adamapell/OpenHornet/ECAD/PCBs/ABSIS/ABSIS_OH_Micro/ABSIS_OH_Micro.kicad_pcb

## KiCad design ECAD/PCBs/ABSIS/ABSIS_OH_Micro/ABSIS_OH_Micro.kicad_pcb (2026-10-13)

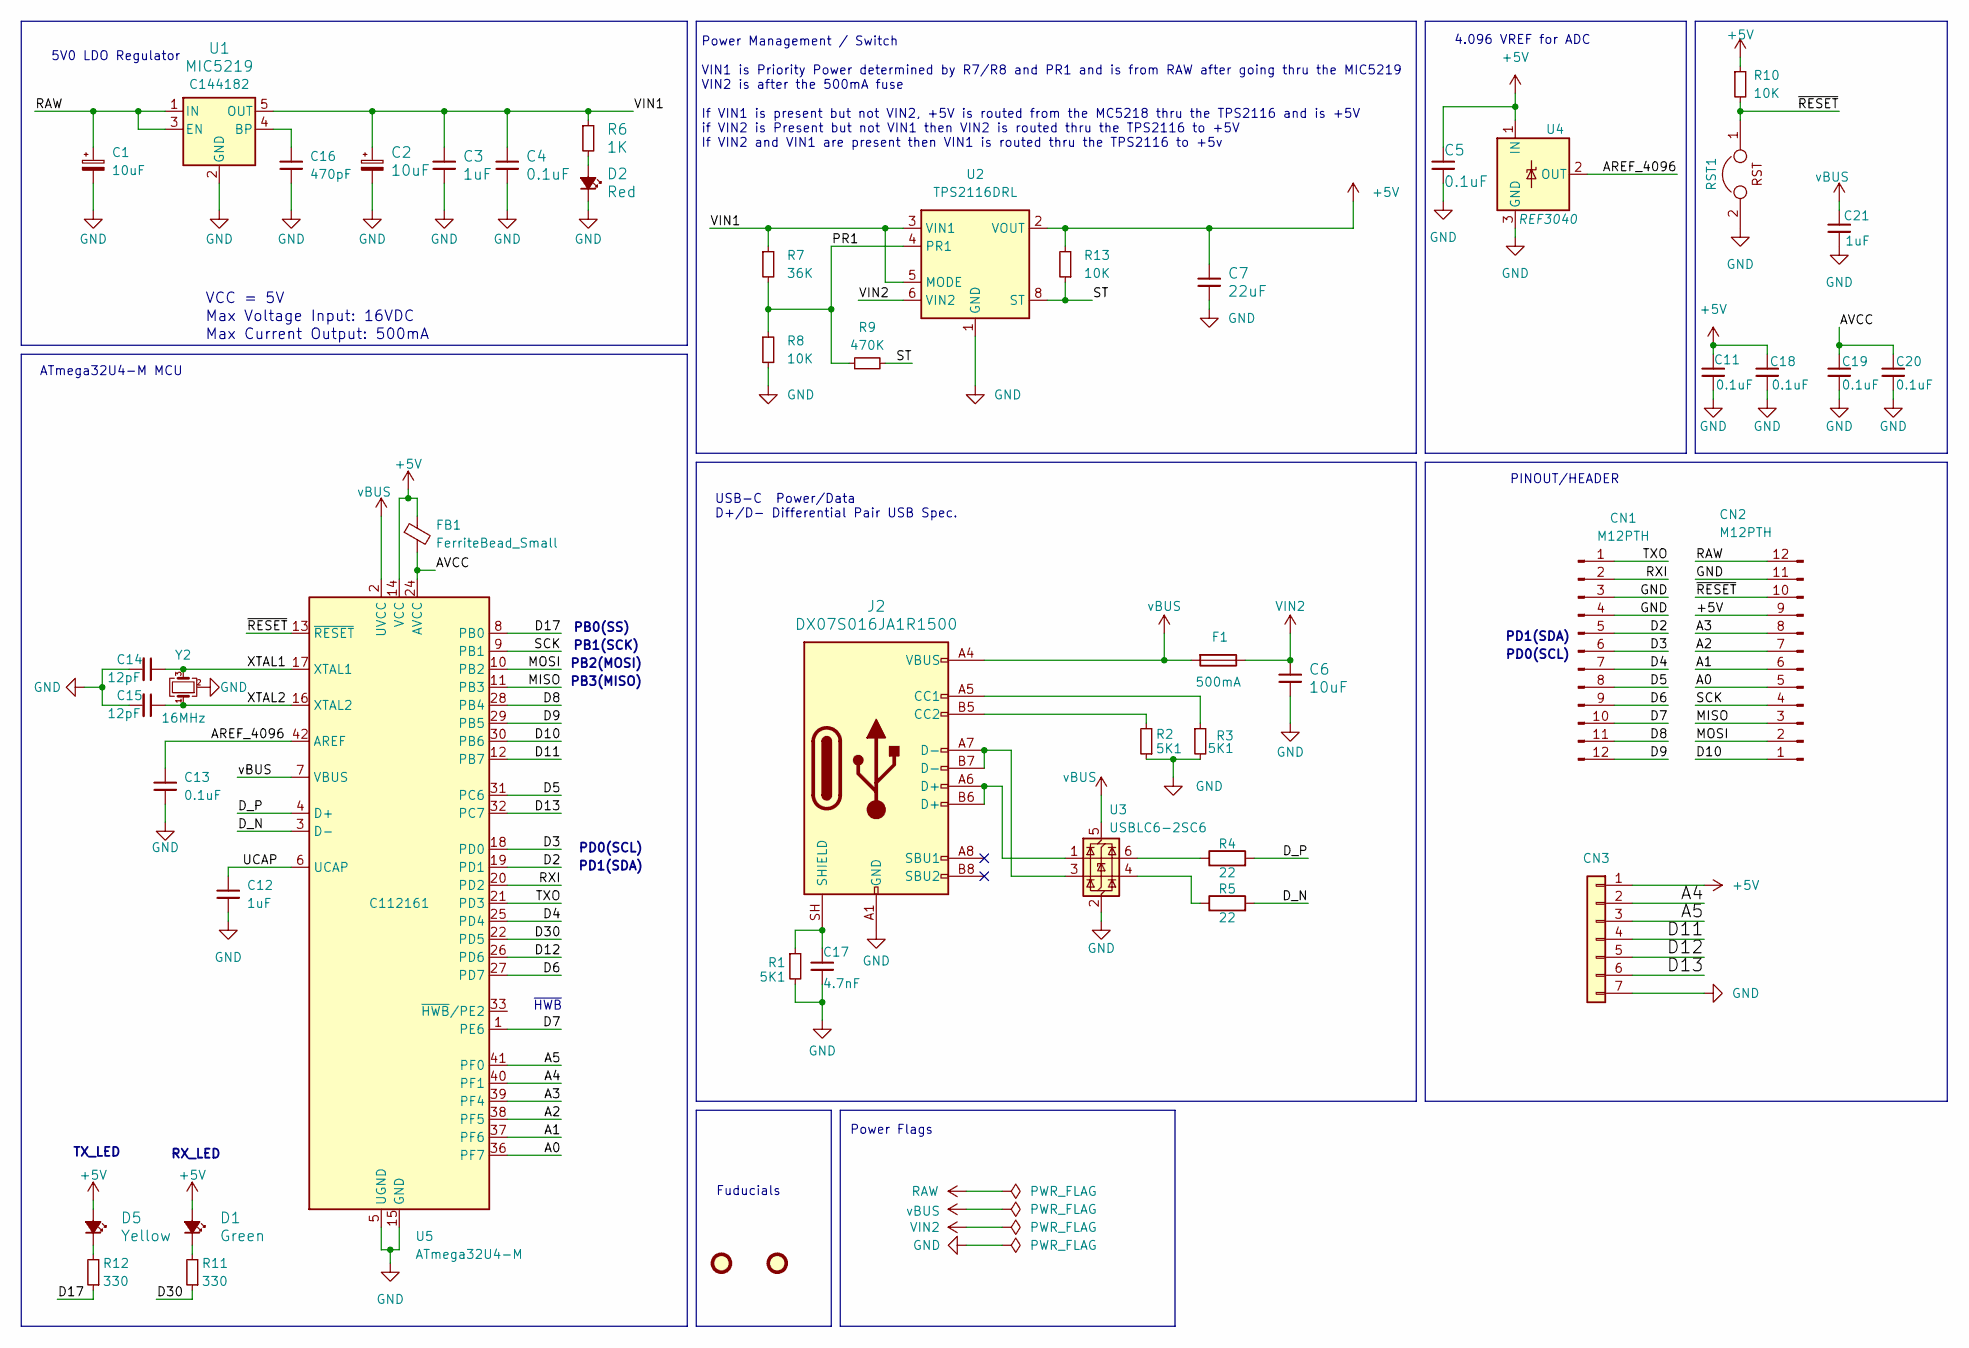
[picture p8: schematic ABSIS_OH_Micro.kicad_sch, ABSIS OH-Micro]

Parts:
C1: 10uF; CP_EIA-3216-18_Kemet-A; LCSC C110055
C2: 10uF; CP_EIA-3216-18_Kemet-A; LCSC Part C110055
C3, C12, C21: 1uF; C_0402_1005Metric; LCSC C1592
C4, C5, C13: 0.1uF; C_0402_1005Metric; LCSC C696360
C6: 10uF; C_0402_1005Metric; LCSC C696360
C7: 22uF; C_0805_2012Metric; LCSC C696360
C11, C18, C19, C20: 0.1uF; C_0402_1005Metric; LCSC C1592
C14, C15: 12pF; C_0402_1005Metric; LCSC C599692
C16: 470pF; C_0402_1005Metric; LCSC C184771
C17: 4.7nF; C_0402_1005Metric; LCSC C1592
CN1, CN2: M12PTH; PinHeader_1x12_P2.54mm_Vertical; LCSC C2840012
CN3: PinHeader_1x06_P2.00mm_Vertical; LCSC C37208
D1: Green; LED_0402_1005Metric; LCSC C74338
D2: Red; LED_0603_1608Metric; LCSC C84263
D5: Yellow; LED_0402_1005Metric; LCSC C434450
F1: 500mA; Fuse_1206_3216Metric; LCSC C136341
FB1: FerriteBead_Small; L_0402_1005Metric
J2: DX07S016JA1R1500; USB_C_Receptacle_JAE_DX07S016JA1R1500; LCSC# C3197885
JP3, JP6: FIDUCIALUFIDUCIAL; Fiducial_0.5mm_Mask1.5mm
R1, R2, R3: 5K1; R_0402_1005Metric; LCSC C844933
R4, R5: 22; R_0402_1005Metric; Manufacturer PN 0603WAF220JT5E; LCSC C23345
R6: 1K; R_0402_1005Metric; LCSC C22548
R7: 36K; R_0402_1005Metric; LCSC C114661
R8, R13: 10K; R_0402_1005Metric; LCSC C99782
R9: 470K; R_0402_1005Metric; LCSC C99782
R10: 10K; R_0402_1005Metric; LCSC C98220
R11, R12: 330; R_0402_1005Metric; LCSC C105881
RST1: RST; SolderJumper-2_P1.3mm_Open_RoundedPad1.0x1.5mm
U1: MIC5219; SOT-23-5; LCSC C144182
U2: TPS2116DRL; SOT-583-8; LCSC C3235557
U3: USBLC6-2SC6; SOT-23-6
U4: REF3040; SOT-23; LCSC C19415
U5: ATmega32U4-M; QFN-44-1EP_7x7mm_P0.5mm_EP5.2x5.2mm; LCSC C112161
Y2: 16MHz; Crystal_SMD_3225-4Pin_3.2x2.5mm; LCSC C13738

Connections:
+5V: C5.2, C7.2, C11.2, C18.2, CN2.9, CN3.1, D1.2 (A), D5.2 (A), FB1.1, R10.1, R13.2, U2.2 (VOUT), U2.7 (VOUT), U4.1 (IN), U5.14 (VCC), U5.34 (VCC)
/A0: CN2.5, U5.36 (PF7)
/A1: CN2.6, U5.37 (PF6)
/A2: CN2.7, U5.38 (PF5)
/A3: CN2.8, U5.39 (PF4)
/A4: CN3.2, U5.40 (PF1)
/A5: CN3.3, U5.41 (PF0)
/AREF_4096: C13.2, U4.2 (OUT), U5.42 (AREF)
/AVCC: C19.2, C20.2, FB1.2, U5.24 (AVCC), U5.44 (AVCC)
/D2: CN1.5, U5.19 (PD1)
/D3: CN1.6, U5.18 (PD0)
/D4: CN1.7, U5.25 (PD4)
/D5: CN1.8, U5.31 (PC6)
/D6: CN1.9, U5.27 (PD7)
/D7: CN1.10, U5.1 (PE6)
/D8: CN1.11, U5.28 (PB4)
/D9: CN1.12, U5.29 (PB5)
/D10: CN2.1, U5.30 (PB6)
/D11: CN3.4, U5.12 (PB7)
/D12: CN3.5, U5.26 (PD6)
/D13: CN3.6, U5.32 (PC7)
/D17: R12.1, U5.8 (PB0)
/D30: R11.1, U5.22 (PD5)
/D_N: R5.2, U5.3 (D-)
/D_P: R4.2, U5.4 (D+)
/MISO: CN2.3, U5.11 (PB3)
/MOSI: CN2.2, U5.10 (PB2)
/PR1: R7.2, R8.1, R9.1, U2.4 (PR1)
/RXI: CN1.2, U5.20 (PD2)
/SCK: CN2.4, U5.9 (PB1)
/ST: R9.2, R13.1, U2.8 (ST)
/TXO: CN1.1, U5.21 (PD3)
/UCAP: C12.2, U5.6 (UCAP)
/VIN1: C2.1, C3.1, C4.2, R6.1, R7.1, U1.5 (OUT), U2.3 (VIN1), U2.5 (MODE)
/XTAL1: C14.1, U5.17 (XTAL1), Y2.3
/XTAL2: C15.1, U5.16 (XTAL2), Y2.1
/~RESET: CN2.10, R10.2, RST1.1, U5.13 (~RESET)
GND: C1.2, C2.2, C3.2, C4.1, C5.1, C6.1, C7.1, C11.1, C12.1, C13.1, C14.2, C15.2, C16.2, C17.1, C18.1, C19.1, C20.1, C21.1, CN1.3, CN1.4, CN2.11, CN3.7, D2.1 (K), J2.A1 (GND), J2.A12 (GND), J2.B1 (GND), J2.B12 (GND), R1.2, R2.1, R3.2, R8.2, RST1.2, U1.2 (GND), U2.1 (GND), U3.2 (GND), U4.3 (GND), U5.5 (UGND), U5.15 (GND), U5.23 (GND), U5.35 (GND), U5.43 (GND), U5.45 (GND), Y2.2 (G), Y2.4 (G)
unnamed: D1.1 (K), R11.2
unnamed: D2.2 (A), R6.2
unnamed: D5.1 (K), R12.2
unnamed: J2.A5 (CC1), R3.1
unnamed: J2.B5 (CC2), R2.2
unnamed: J2.A6 (D+), J2.B6 (D+), U3.1 (I/O1)
unnamed: J2.A7 (D-), J2.B7 (D-), U3.3 (I/O2)
unnamed: C17.2, J2.SH (SHIELD), R1.1
unnamed: R4.1, U3.6 (I/O1)
unnamed: R5.1, U3.4 (I/O2)
unnamed: C16.1, U1.4 (BP)
RAW: C1.1, CN2.12, U1.1 (IN), U1.3 (EN)
VIN2: C6.2, F1.1, U2.6 (VIN2)
vBUS: C21.2, F1.2, J2.A4 (VBUS), J2.A9 (VBUS), J2.B4 (VBUS), J2.B9 (VBUS), U3.5 (VBUS), U5.2 (UVCC), U5.7 (VBUS)

Notes on the sheet:
PB0(SS)
RX_LED
5V0 LDO Regulator
PB2(MOSI)
PD0(SCL)
PB1(SCK)
USB-C Power/Data D+/D- Differential Pair USB Spec.
~{HWB}
4.096 VREF for ADC
Fuducials
PD1(SDA)
Max Voltage Input: 16VDC
TX_LED
Max Current Output: 500mA
ATmega32U4-M MCU
Power Flags
PB3(MISO)
PINOUT/HEADER
VCC = 5V
Power Management / Switch VIN1 is Priority Power determined by R7/R8 and PR1 and is from RAW after going thru the MIC5219 VIN2 is after the 500mA fuse If VIN1 is present but not VIN2, +5V is routed from the MC5218 thru the TPS2116 and is +5V if VIN2 is Present but not VIN1 then VIN2 is routed thru 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

Board: 4 copper layers, 50 parts (4 on the bottom side), 52 nets, no tracks yet.

Other parts of the board:
LOGO: LOGO; LOGO_OH_NoText_Small
