adamapell/OpenHornet/ECAD/PCBs/ABSIS/ABSIS_ALE+/ABSIS ALE+.kicad_pcb

## KiCad design ECAD/PCBs/ABSIS/ABSIS_ALE+/ABSIS ALE+.kicad_pcb (2026-07-24)

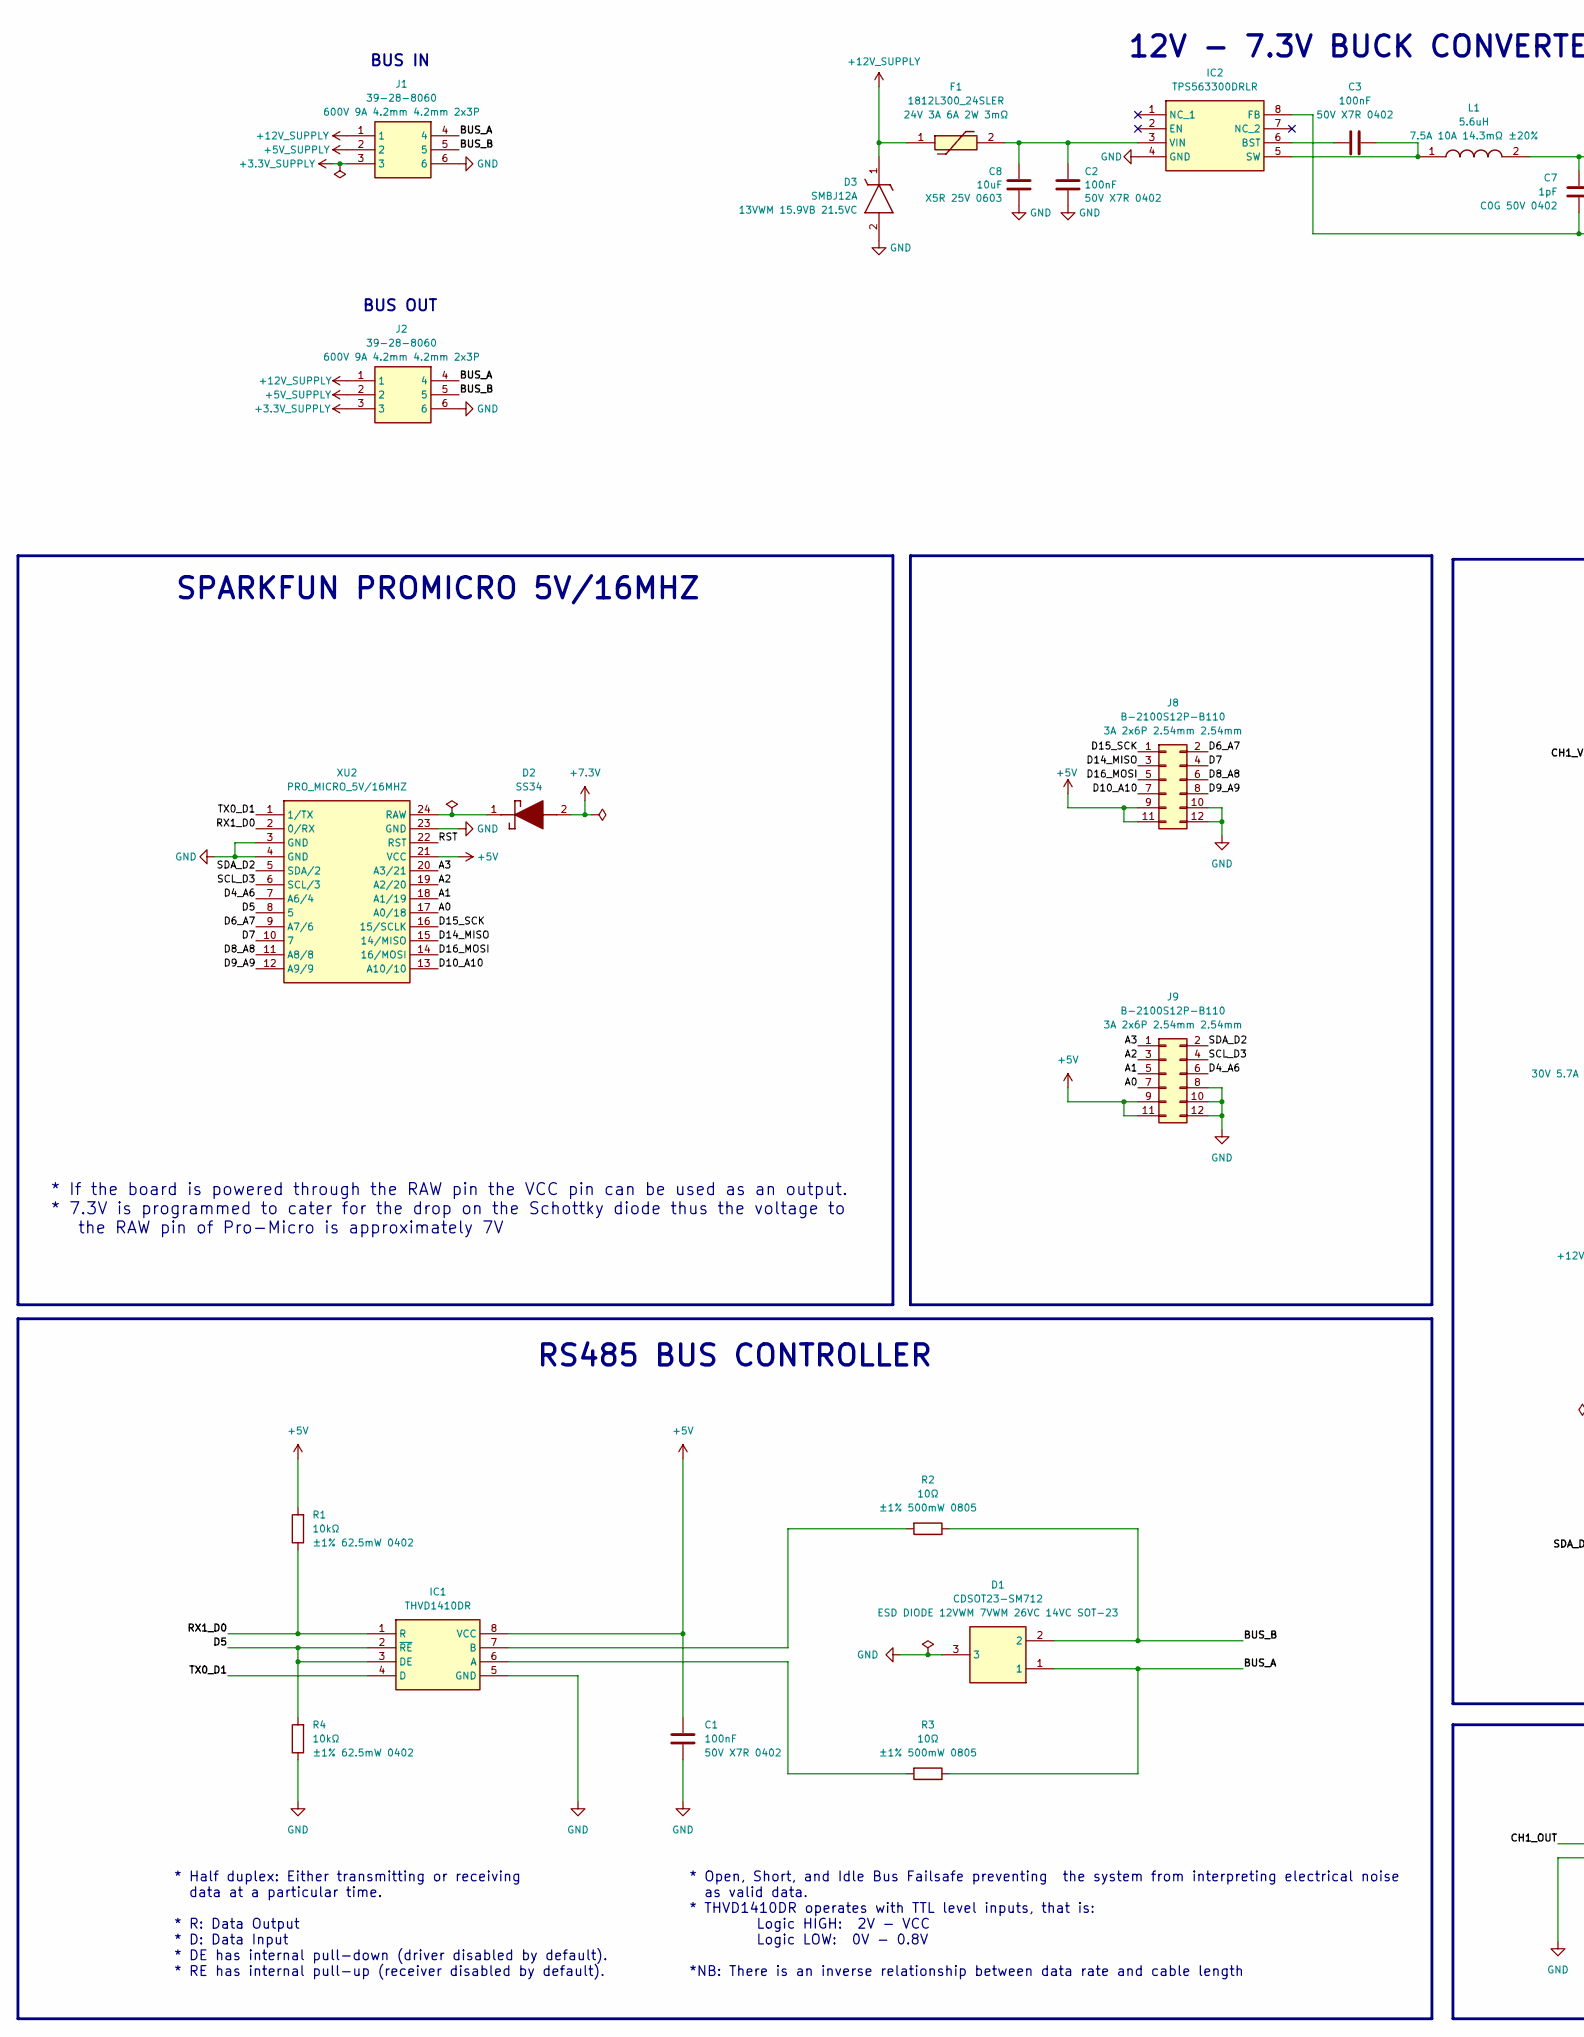
[picture p9: schematic ABSIS ALE+.kicad_sch, ABSIS ALE (ALmost Everything), part in row 1, column 1]

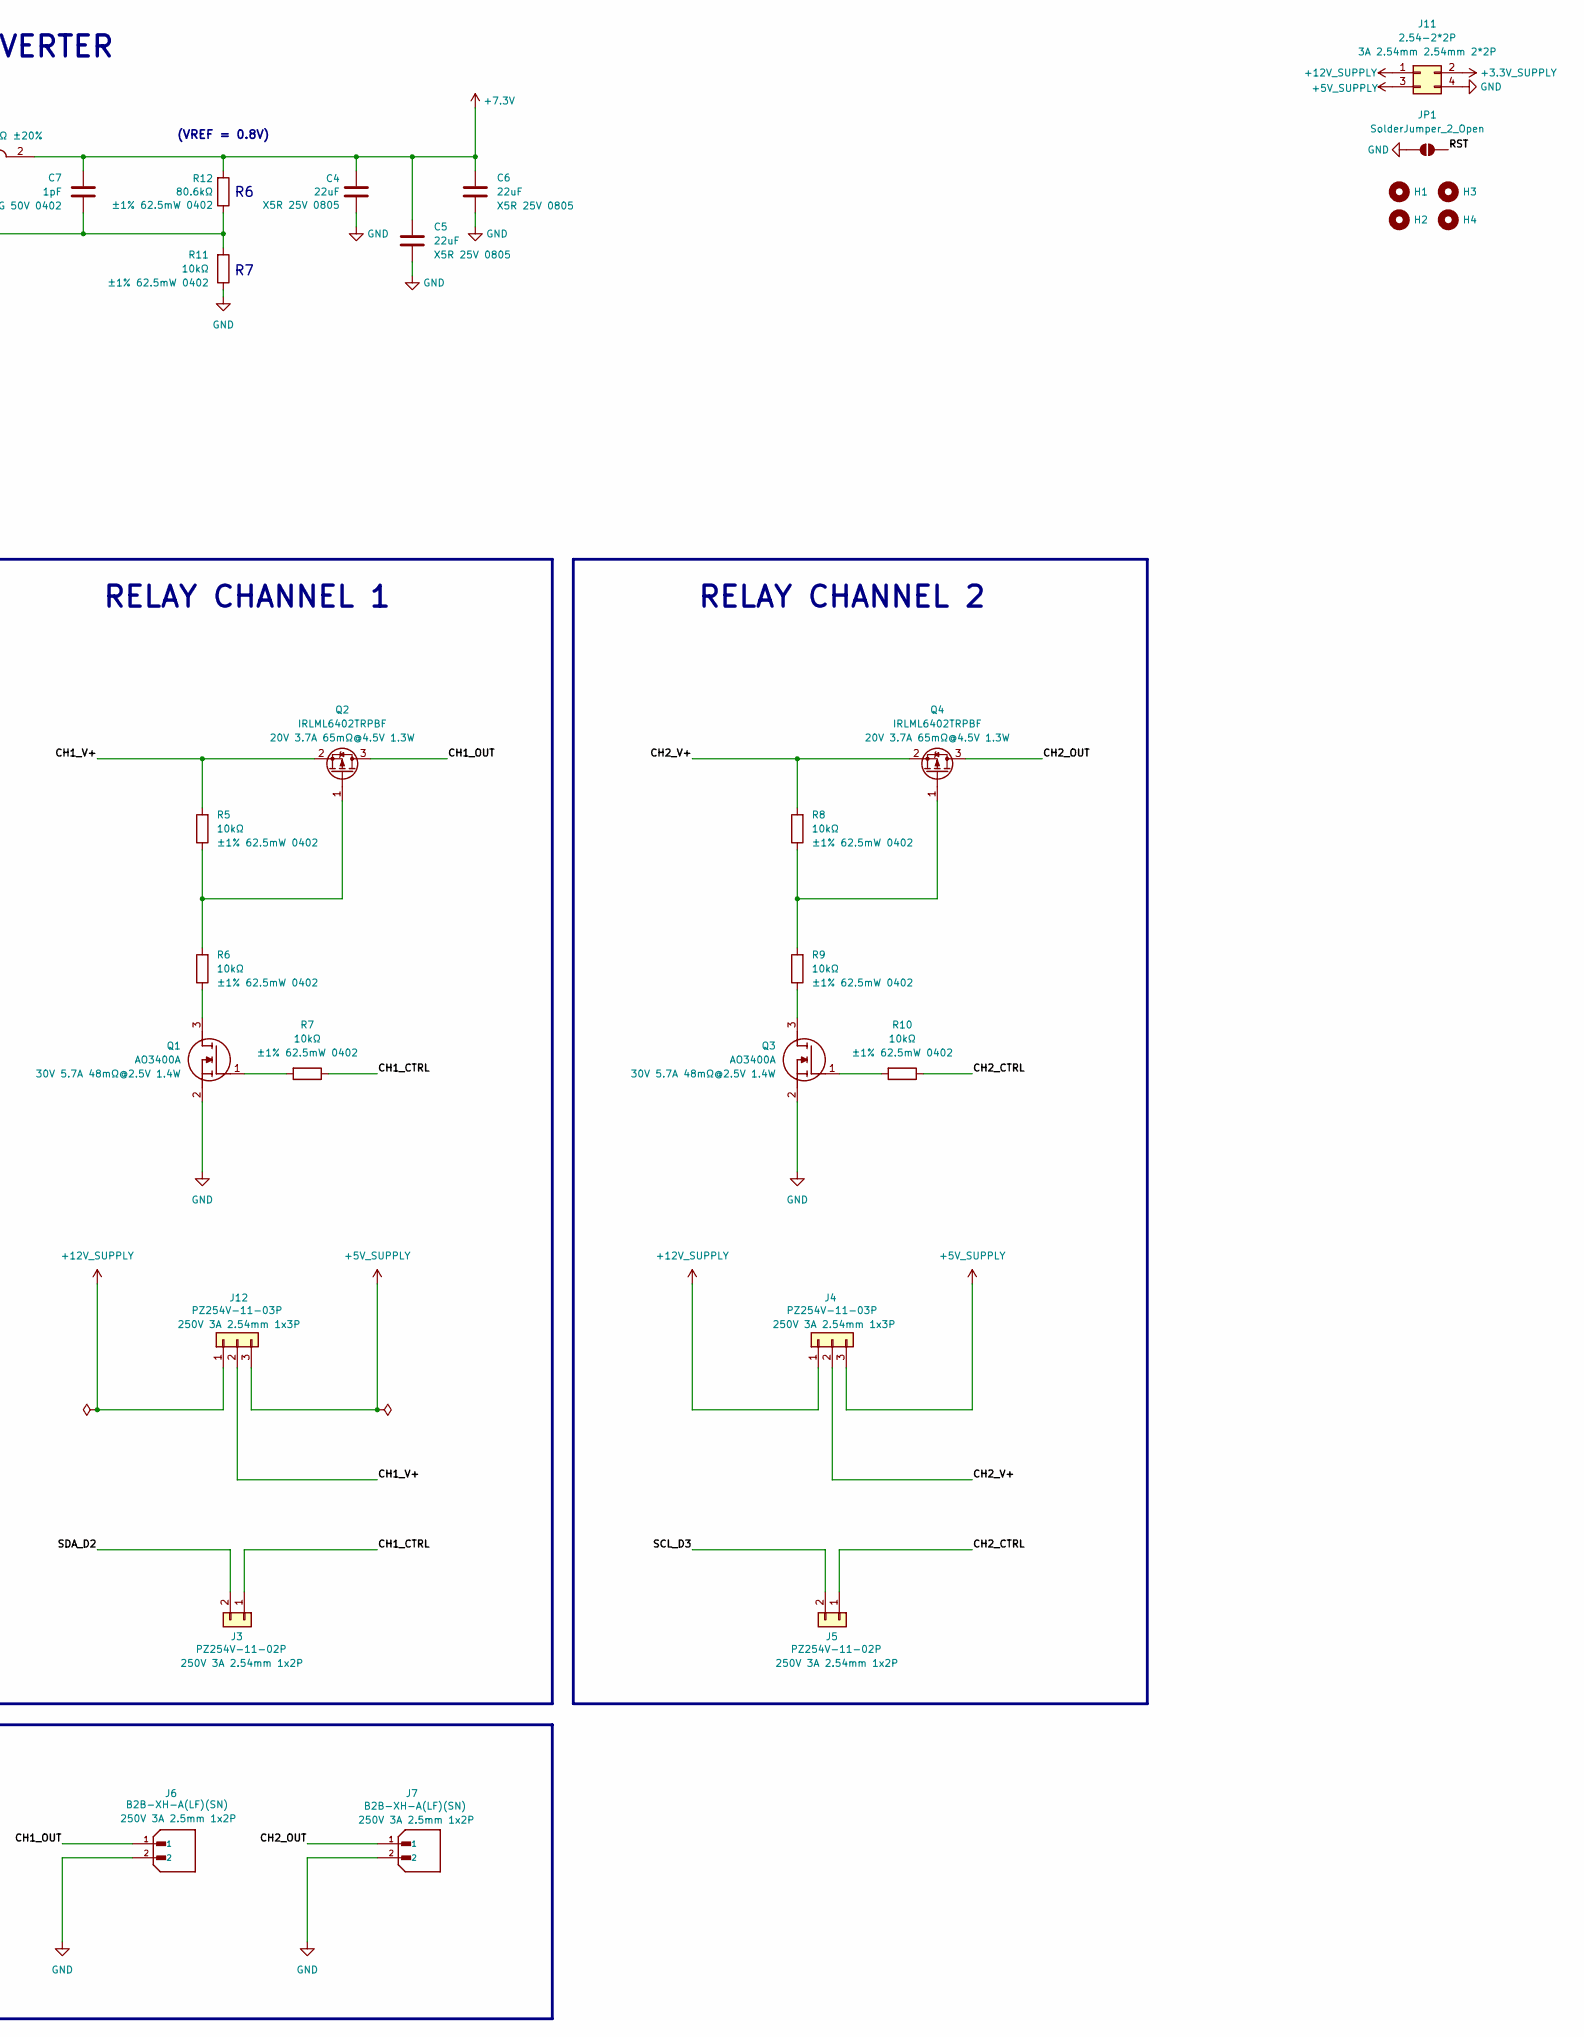
[picture p10: schematic ABSIS ALE+.kicad_sch, ABSIS ALE (ALmost Everything), part in row 1, column 2]

Parts:
C1, C2, C3: 100nF; C_0402_1005Metric; Manufacturer PN CL05B104KB54PNC; LCSC C307331
C4, C5, C6: 22uF; C_0805_2012Metric; Manufacturer PN CL21A226MAQNNNE; LCSC C45783
C7: 1pF; C_0402_1005Metric; Manufacturer PN 0402CG1R0C500NT; LCSC C1550
C8: 10uF; C_0603_1608Metric; Manufacturer PN CL10A106MA8NRNC; LCSC C96446
D1: CDSOT23-SM712; Manufacturer PN CDSOT23-SM712; LCSC C404012
D2: SS34; Manufacturer PN SS34; LCSC C8678
D3: SMBJ12A; Manufacturer PN SMBJ12A; LCSC C151251
F1: 1812L300_24SLER; Manufacturer PN 1812L300/24SLER; LCSC C1512049
H1, H2, H3, H4: MountingHole; MountingHole_3.2mm_M3_DIN965
IC1: THVD1410DR; Manufacturer PN THVD1410DR; LCSC C2671345
IC2: TPS563300DRLR; Manufacturer PN TPS563300DRLR; LCSC C5219249
J1, J2: 39-28-8060; Manufacturer PN 39288060; LCSC C505058
J3, J5: PZ254V-11-02P; PinHeader_1x02_P2.54mm_Vertical; Manufacturer PN PZ254V-11-02P; LCSC C492401
J4, J12: PZ254V-11-03P; PinHeader_1x03_P2.54mm_Vertical; Manufacturer PN PZ254V-11-03P; LCSC C2937625
J6, J7: B2B-XH-A(LF)(SN); B2B-XH-A__LF__SN_; Manufacturer PN B2B-XH-A(LF)(SN); LCSC C158012
J8, J9: B-2100S12P-B110; PinHeader_2x06_P2.54mm_Vertical; Manufacturer PN B-2100S12P-B110; LCSC C124388
J11: 2.54-2*2P; PinHeader_2x02_P2.54mm_Vertical; Manufacturer PN 2.54-2*2P; LCSC C66690
JP1: SolderJumper_2_Open; SolderJumper-2_P1.3mm_Open_RoundedPad1.0x1.5mm
L1: 5.6uH; SRP6060FA-5R6M; Manufacturer PN SRP6060FA-5R6M; LCSC C1332221
Q1, Q3: AO3400A; Manufacturer PN AO3400A; LCSC C20917
Q2, Q4: IRLML6402TRPBF; Manufacturer PN IRLML6402TRPBF; LCSC C2593
R1, R4, R5, R6, R7, R8, R9, R10, R11: 10kΩ; R_0402_1005Metric; Manufacturer PN 0402WGF1002TCE; LCSC C25744
R2, R3: 10Ω; R_0805_2012Metric; Manufacturer PN CRCW080510R0FKEAHP; LCSC C844598
R12: 80.6kΩ; R_0402_1005Metric; Manufacturer PN 0402WGF8062TCE; LCSC C25921
XU2: PRO_MICRO_5V/16MHZ; PRO_MICRO_5V16MHZ; Manufacturer PN PRO_MICRO_5V/16MHZ

Connections:
+3.3V_SUPPLY: J1.3, J2.3, J11.2
+5V: C1.2, IC1.8 (VCC), J8.9, J8.11, J9.9, J9.11, R1.2, XU2.21 (VCC)
+5V_SUPPLY: J1.2, J2.2, J4.3, J11.3, J12.3
+7.3V: C4.1, C5.1, C6.1, C7.1, D2.2 (A), L1.2, R12.2
+12V_SUPPLY: D3.1 (K), F1.1, J1.1, J2.1, J4.1, J11.1, J12.1
/A0: J9.7, XU2.17 (A0/18)
/A1: J9.5, XU2.18 (A1/19)
/A2: J9.3, XU2.19 (A2/20)
/A3: J9.1, XU2.20 (A3/21)
/BUS_A: D1.1, J1.4, J2.4, R3.1
/BUS_B: D1.2, J1.5, J2.5, R2.1
/CH1_CTRL: J3.1, R7.1
/CH1_OUT: J6.1, Q2.3
/CH1_V+: J12.2, Q2.2, R5.2
/CH2_CTRL: J5.1, R10.1
/CH2_OUT: J7.1, Q4.3
/CH2_V+: J4.2, Q4.2, R8.2
/D4_A6: J9.6, XU2.7 (A6/4)
/D5: IC1.2 (~RE), IC1.3 (DE), R4.2, XU2.8 (5)
/D6_A7: J8.2, XU2.9 (A7/6)
/D7: J8.4, XU2.10 (7)
/D8_A8: J8.6, XU2.11 (A8/8)
/D9_A9: J8.8, XU2.12 (A9/9)
/D10_A10: J8.7, XU2.13 (A10/10)
/D14_MISO: J8.3, XU2.15 (14/MISO)
/D15_SCK: J8.1, XU2.16 (15/SCLK)
/D16_MOSI: J8.5, XU2.14 (16/MOSI)
/FB(TPS): C7.2, IC2.8 (FB), R11.2, R12.1
/RST: JP1.2 (B), XU2.22 (RST)
/RX1_D0: IC1.1 (R), R1.1, XU2.2 (0/RX)
/SCL_D3: J5.2, J9.4, XU2.6 (SCL/3)
/SDA_D2: J3.2, J9.2, XU2.5 (SDA/2)
/TX0_D1: IC1.4 (D), XU2.1 (1/TX)
GND: C1.1, C2.1, C4.2, C5.2, C6.2, C8.1, D1.3, D3.2 (A), IC1.5 (GND), IC2.4 (GND), J1.6, J2.6, J6.2, J7.2, J8.10, J8.12, J9.8, J9.10, J9.12, J11.4, JP1.1 (A), Q1.2 (S), Q3.2 (S), R4.1, R11.1, XU2.3 (GND), XU2.4 (GND), XU2.23 (GND)
unnamed: D2.1 (K), XU2.24 (RAW)
unnamed: IC1.6 (A), R3.2
unnamed: IC1.7 (B), R2.2
unnamed: C3.2, IC2.6 (BST)
unnamed: C3.1, IC2.5 (SW), L1.1
unnamed: C2.2, C8.2, F1.2, IC2.3 (VIN)
unnamed: Q1.3 (D), R6.1
unnamed: Q1.1 (G), R7.2
unnamed: Q2.1, R5.1, R6.2
unnamed: Q3.3 (D), R9.1
unnamed: Q3.1 (G), R10.2
unnamed: Q4.1, R8.1, R9.2

Notes on the sheet:
BUS IN
(VREF = 0.8V)
BUS OUT
SPARKFUN PROMICRO 5V/16MHZ
12V - 7.3V BUCK CONVERTER
RELAY CHANNEL 1
* Open, Short, and Idle Bus Failsafe preventing the system from interpreting electrical noise as valid data. * THVD1410DR operates with TTL level inputs, that is: Logic HIGH: 2V - VCC Logic LOW: 0V - 0.8V *NB: There is an inverse relationship between data rate and cable length
RELAY CHANNEL 2
RS485 BUS CONTROLLER
* If the board is powered through the RAW pin the VCC pin can be used as an output. * 7.3V is programmed to cater for the drop on the Schottky diode thus the voltage to the RAW pin of Pro-Micro is approximately 7V
* Half duplex: Either transmitting or receiving data at a particular time. * R: Data Output * D: Data Input * DE has internal pull-down (driver disabled by default). * RE has internal pull-up (receiver disabled by default).

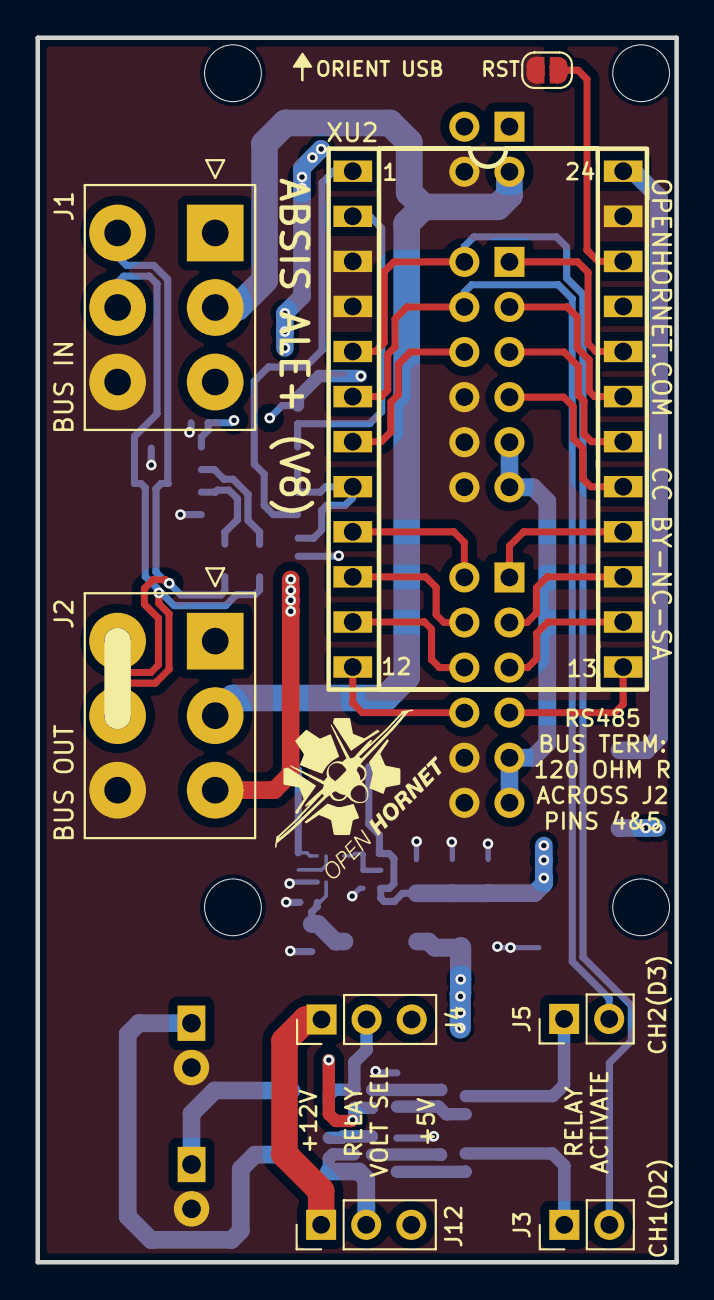
[picture p11: board ABSIS ALE+.kicad_pcb from above]

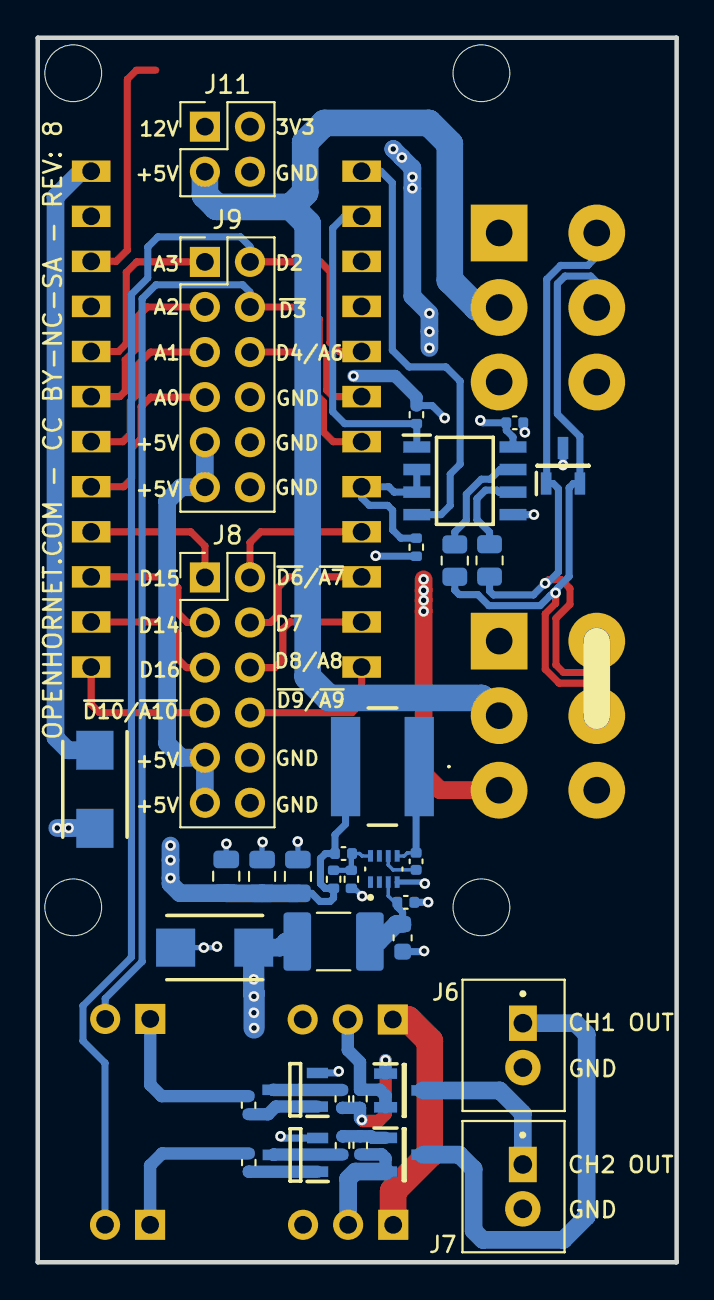
[picture p12: board ABSIS ALE+.kicad_pcb from below]

Board: 4 copper layers, 36.0 x 69.0 mm, 48 parts (36 on the bottom side), 46 nets.
