adamapell/OpenHornet/(commit log)

2026-07-24 Partial ALE+ work
    [ABSIS ALE+.kicad_pcb, ABSIS ALE+.kicad_sch]
2026-10-07 Initial Create of Schematic and PCB outline constraints
