adamapell/OpenHornet/(notices)

Notices in the files:
ECAD/PCBs/ABSIS/ABSIS_ALE+/ABSIS ALE+.kicad_pcb:
License: CC BY-NC-SA
OPENHORNET.COM - CC BY-NC-SA
OPENHORNET.COM - CC BY-NC-SA - REV: 8
